Jochen0x90h/RoomControl_old/(list of files, cad)

Other CAD files:
cad/box.scad
