Jochen0x90h/RoomControl_old/hardware/main/main.kicad_pcb

## KiCad design hardware/main/main.kicad_pcb (2020-09-15)

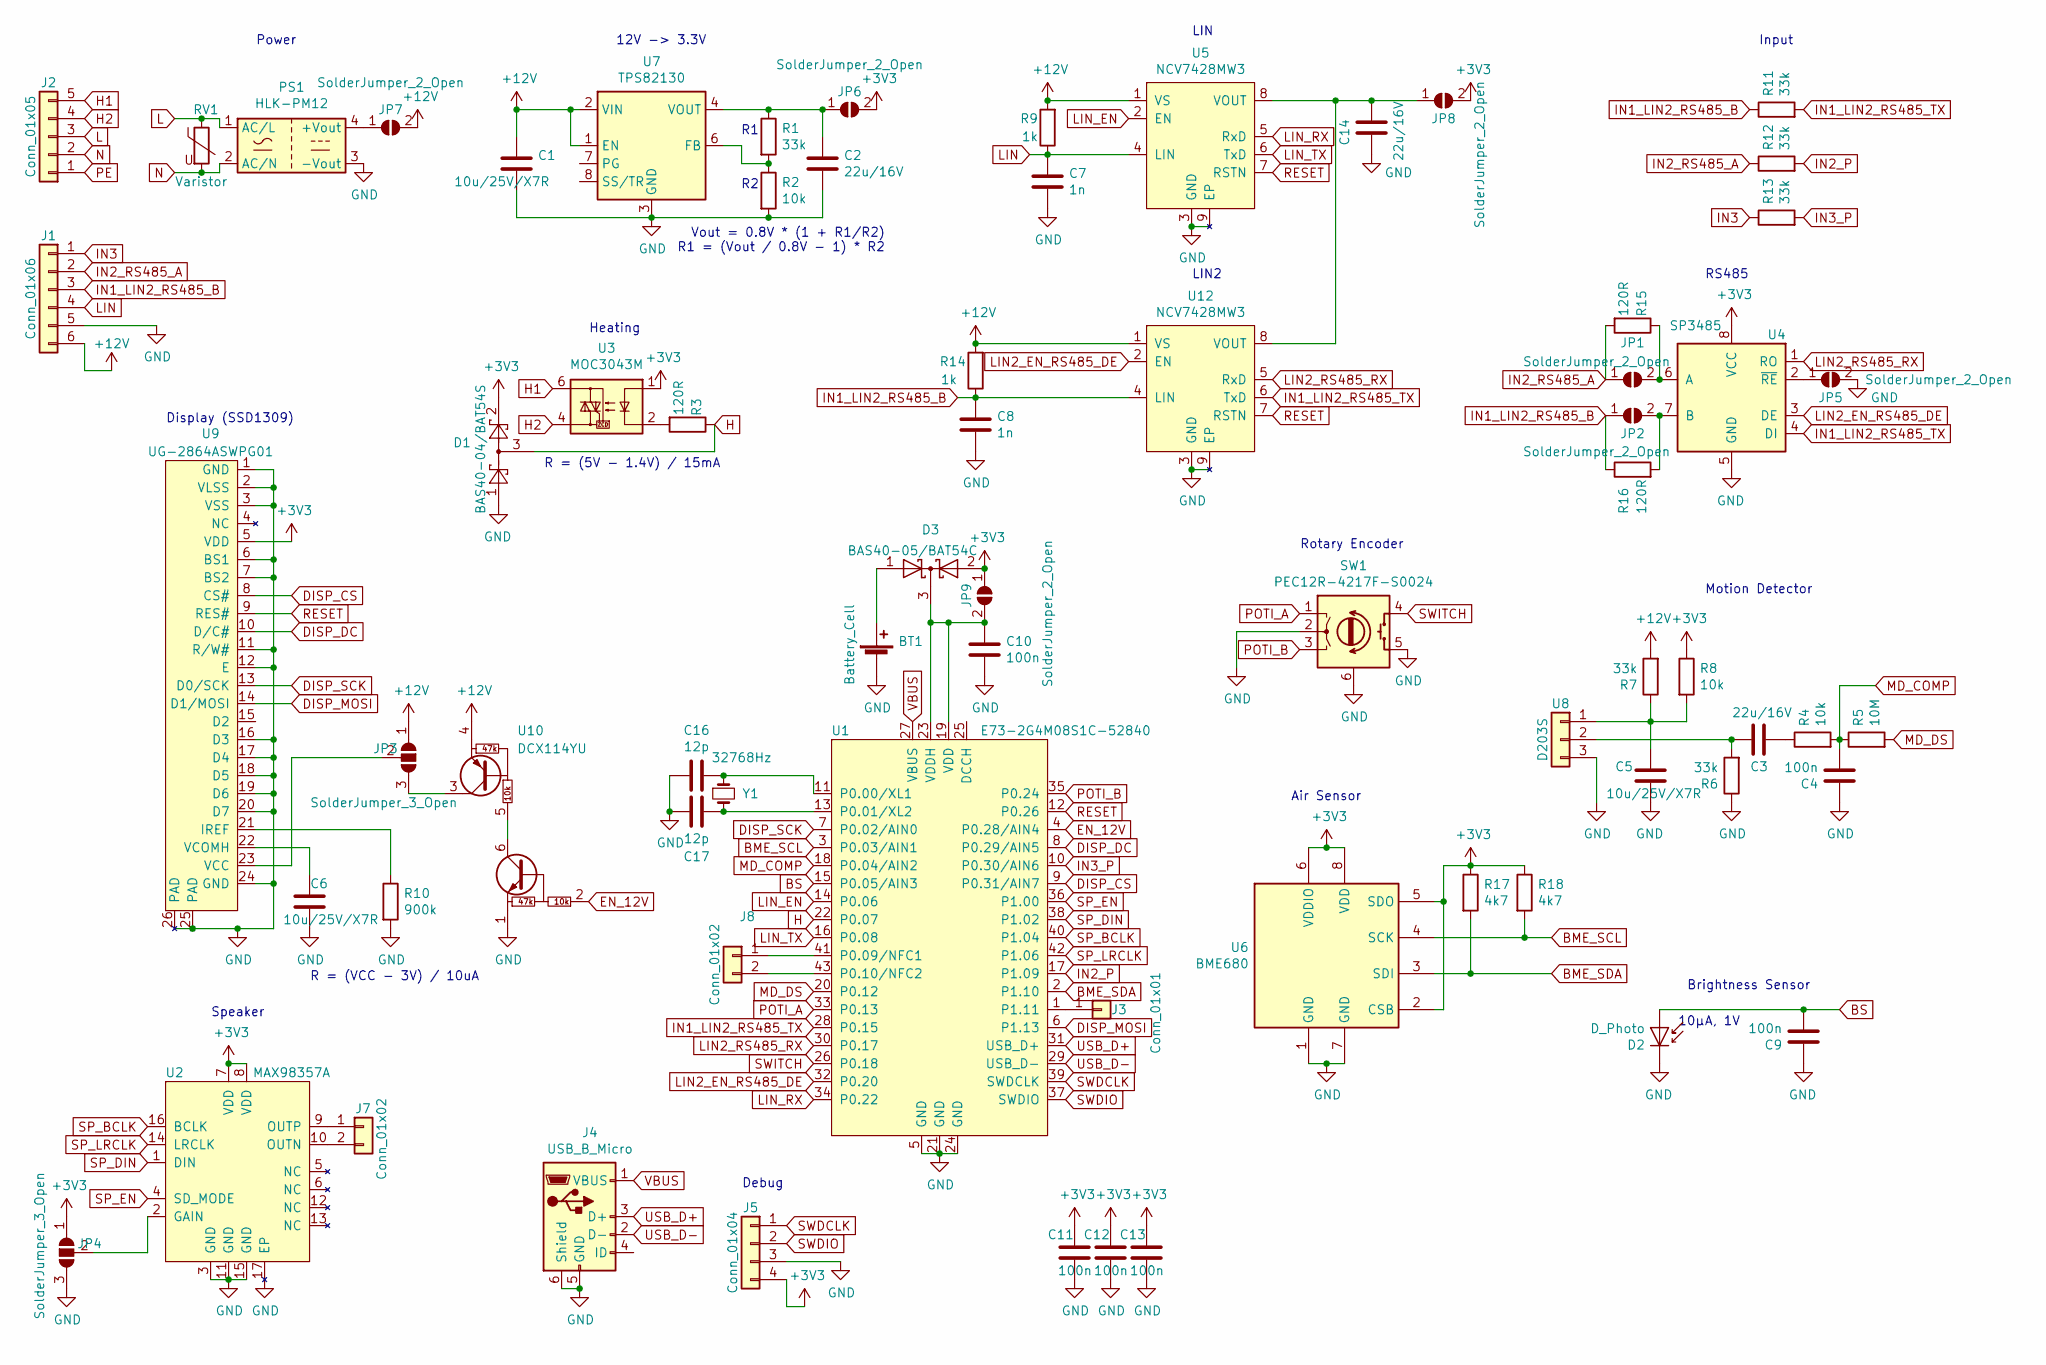
[picture p1: schematic main.sch]

Parts:
BT1: Battery_Cell; Battery_2032
C1, C5, C6: 10u/25V/X7R; C_1206_3216Metric
C2, C3, C14: 22u/16V; C_0805_2012Metric
C4, C9, C10, C11, C12, C13: 100n; C_0603_1608Metric
C7, C8: 1n; C_0603_1608Metric
C16, C17: 12p; C_0603_1608Metric
D1: BAS40-04/BAT54S; SOT-23
D2: D_Photo; DiodeHoles
D3: BAS40-05/BAT54C; SOT-23
J1: Conn_01x06; Wago_236-406
J2: Conn_01x05; Wago_236-405
J3: Conn_01x01; Pad
J4: USB_B_Micro; USB_Micro-B
J5: Conn_01x04; PinHeader_1x04_P2.54mm_Vertical
J7: Conn_01x02; PinHeader_1x02_P2.54mm_Vertical
J8: Conn_01x02; PinHeader_1x02_P2.00mm_Vertical
JP1, JP2, JP5, JP6, JP7, JP8, JP9: SolderJumper_2_Open; Jumper2
JP3, JP4: SolderJumper_3_Open; Jumper3
PS1: HLK-PM12; HiLink_HLK-PMxx
R1, R6, R7: 33k; R_0603_1608Metric
R2, R4, R8: 10k; R_0603_1608Metric
R3, R15, R16: 120R; R_1206_3216Metric
R5: 10M; R_0603_1608Metric
R9, R14: 1k; R_1206_3216Metric
R10: 900k; R_0603_1608Metric
R11, R12, R13: 33k; R_1206_3216Metric
R17, R18: 4k7; R_0603_1608Metric
RV1: Varistor; S10K275
SW1: PEC12R-4217F-S0024; Bourns_PEC12R
U1: E73-2G4M08S1C-52840
U2: MAX98357A; TQFN-16-1EP_3x3mm_P0.5mm_EP1.23x1.23mm
U3: MOC3043M; On_MOC3043
U4: SP3485; SOIC-8_3.9x4.9mm_P1.27mm
U5, U12: NCV7428MW3; On_NCV7428MW
U6: BME680; Bosch_BME680
U7: TPS82130; Texas_TPS82130
U8: D203S
U9: UG-2864ASWPG01; Connector-Flat-24_P0.5mm
U10: DCX114YU; SOT-363_SC-70-6
Y1: 32768Hz; Crystal_DS26_D2.0mm_L6.0mm_Vertical

Connections:
+3V3: C11.2, C12.2, C13.2, D1.2, D3.2 (A), J5.4, JP4.1 (A), JP6.2 (B), JP8.2 (B), JP9.1 (A), R8.1, R17.1, R18.1, U2.7 (VDD), U2.8 (VDD), U3.1, U4.8 (VCC), U6.2 (CSB), U6.5 (SDO), U6.6 (VDDIO), U6.8 (VDD), U9.5 (VDD)
+12V: C1.1, J1.6, JP3.1 (A), JP7.2 (B), R7.2, R9.2, R14.2, U5.1 (VS), U7.1 (EN), U7.2 (VIN), U10.4 (C2), U12.1 (VS)
BME_SCL: R18.2, U1.3 (P0.03/AIN1), U6.4 (SCK)
BME_SDA: R17.2, U1.2 (P1.10), U6.3 (SDI)
BS: C9.2, D2.2 (A), U1.15 (P0.05/AIN3)
DISP_CS: U1.9 (P0.31/AIN7), U9.8 (CS#)
DISP_DC: U1.8 (P0.29/AIN5), U9.10 (D/C#)
DISP_MOSI: U1.6 (P1.13), U9.14 (D1/MOSI)
DISP_SCK: U1.7 (P0.02/AIN0), U9.13 (D0/SCK)
EN_12V: U1.4 (P0.28/AIN4), U10.2 (B1)
GND: BT1.2 (-), C1.2, C2.2, C4.1, C5.2, C6.2, C7.2, C8.2, C9.1, C10.2, C11.1, C12.1, C13.1, C14.1, C16.2, C17.2, D1.1, D2.1 (K), J1.5, J4.5 (GND), J4.6 (Shield), J5.3, JP4.3 (B), JP5.2 (B), PS1.3 (-Vout), R2.2, R6.1, R10.2, SW1.2 (C), SW1.5 (S2), SW1.6 (SH), U1.5 (GND), U1.21 (GND), U1.24 (GND), U2.3 (GND), U2.11 (GND), U2.15 (GND), U2.17 (EP), U4.5 (GND), U5.3 (GND), U5.9 (EP), U6.1 (GND), U6.7 (GND), U7.3 (GND), U7.9 (GND), U8.3, U9.1 (GND), U9.2 (VLSS), U9.3 (VSS), U9.6 (BS1), U9.7 (BS2), U9.11 (R/W#), U9.12 (E), U9.16 (D3), U9.17 (D4), U9.18 (D5), U9.19 (D6), U9.20 (D7), U9.24 (GND), U9.25 (PAD), U9.26 (PAD), U10.1 (E1), U12.3 (GND), U12.9 (EP)
H: D1.3, R3.1, U1.22 (P0.07)
H1: J2.5, U3.6
H2: J2.4, U3.4
IN1_LIN2_RS485_B: C8.1, J1.3, JP2.1 (A), R11.1, R14.1, R16.1, U12.4 (LIN)
IN1_LIN2_RS485_TX: R11.2, U1.28 (P0.15), U4.4 (DI), U12.6 (TxD)
IN2_P: R12.2, U1.17 (P1.09)
IN2_RS485_A: J1.2, JP1.1 (A), R12.1, R15.2
IN3: J1.1, R13.1
IN3_P: R13.2, U1.10 (P0.30/AIN6)
L: J2.3, PS1.1 (AC/L), RV1.1
LIN: C7.1, J1.4, R9.1, U5.4 (LIN)
LIN2_EN_RS485_DE: U1.32 (P0.20), U4.3 (DE), U12.2 (EN)
LIN2_RS485_RX: U1.30 (P0.17), U4.1 (RO), U12.5 (RxD)
LIN_EN: U1.14 (P0.06), U5.2 (EN)
LIN_RX: U1.34 (P0.22), U5.5 (RxD)
LIN_TX: U1.16 (P0.08), U5.6 (TxD)
MD_COMP: C4.2, R4.2, R5.1, U1.18 (P0.04/AIN2)
MD_DS: R5.2, U1.20 (P0.12)
N: J2.2, PS1.2 (AC/N), RV1.2
unnamed: BT1.1 (+), D3.1 (A)
unnamed: C2.1, JP6.1 (A), R1.1, U7.4 (VOUT), U7.5 (VOUT)
unnamed: C3.1, R4.1
unnamed: C3.2, R6.2, U8.2
unnamed: C5.1, R7.1, R8.2, U8.1
unnamed: C6.1, U9.22 (VCOMH)
unnamed: C10.1, D3.3 (K), JP9.2 (B), U1.19 (VDD), U1.23 (VDDH)
unnamed: C14.2, JP8.1 (A), U5.8 (VOUT), U12.8 (VOUT)
unnamed: C16.1, U1.11 (P0.00/XL1), Y1.1
unnamed: C17.1, U1.13 (P0.01/XL2), Y1.2
unnamed: J3.1, U1.1 (P1.11)
unnamed: J7.1, U2.9 (OUTP)
unnamed: J7.2, U2.10 (OUTN)
unnamed: J8.1, U1.41 (P0.09/NFC1)
unnamed: J8.2, U1.43 (P0.10/NFC2)
unnamed: JP1.2 (B), R15.1, U4.6 (A)
unnamed: JP2.2 (B), R16.2, U4.7 (B)
unnamed: JP3.2 (C), U9.23 (VCC)
unnamed: JP3.3 (B), U10.3 (C2)
unnamed: JP4.2 (C), U2.2 (GAIN)
unnamed: JP5.1 (A), U4.2 (~RE~)
unnamed: JP7.1 (A), PS1.4 (+Vout)
unnamed: R1.2, R2.1, U7.6 (FB)
unnamed: R3.2, U3.2
unnamed: R10.1, U9.21 (IREF)
unnamed: U10.5 (B2), U10.6 (C1)
PE: J2.1
POTI_A: SW1.1 (A), U1.33 (P0.13)
POTI_B: SW1.3 (B), U1.35 (P0.24)
RESET: U1.12 (P0.26), U5.7 (RSTN), U9.9 (RES#), U12.7 (RSTN)
SP_BCLK: U1.40 (P1.04), U2.16 (BCLK)
SP_DIN: U1.38 (P1.02), U2.1 (DIN)
SP_EN: U1.36 (P1.00), U2.4 (SD_MODE)
SP_LRCLK: U1.42 (P1.06), U2.14 (LRCLK)
SWDCLK: J5.1, U1.39 (SWDCLK)
SWDIO: J5.2, U1.37 (SWDIO)
SWITCH: SW1.4 (S1), U1.26 (P0.18)
USB_D+: J4.3 (D+), U1.31 (USB_D+)
USB_D-: J4.2 (D-), U1.29 (USB_D-)
VBUS: J4.1 (VBUS), U1.27 (VBUS)

Notes on the sheet:
Vout = 0.8V * (1 + R1/R2) R1 = (Vout / 0.8V - 1) * R2
R = (VCC - 3V) / 10uA
Motion Detector
Display (SSD1309)
Speaker
Brightness Sensor
Input
LIN
RS485
12V -> 3.3V
Rotary Encoder
Air Sensor
Power
Heating
10µA, 1V
R = (5V - 1.4V) / 15mA
LIN2
Debug

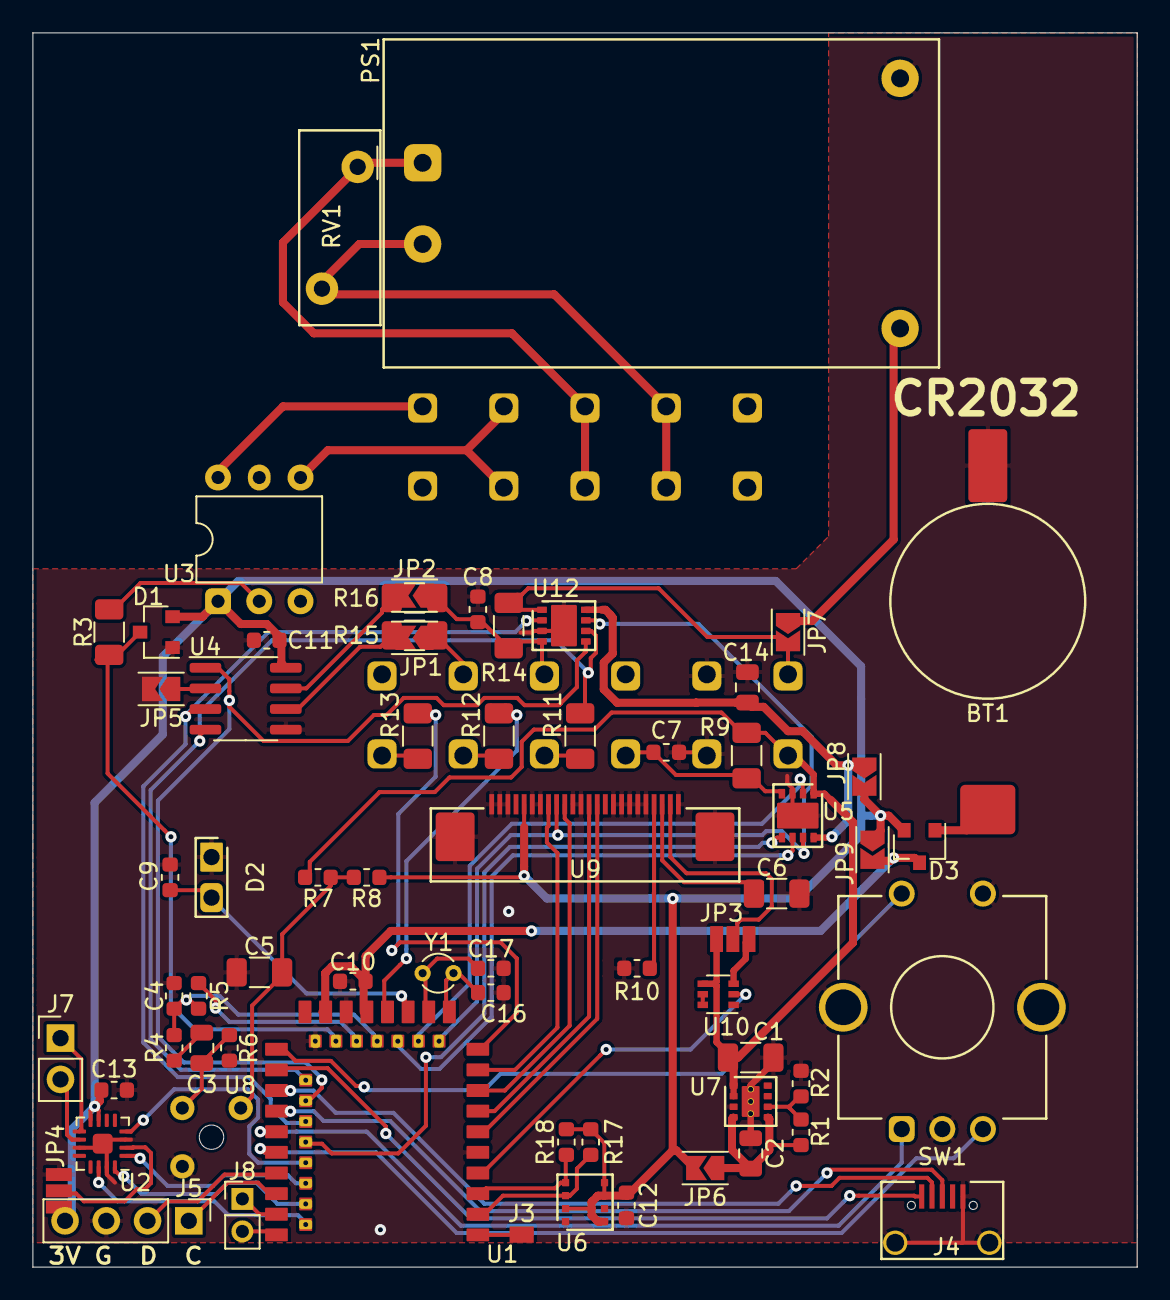
[picture p2: board main.kicad_pcb from above]

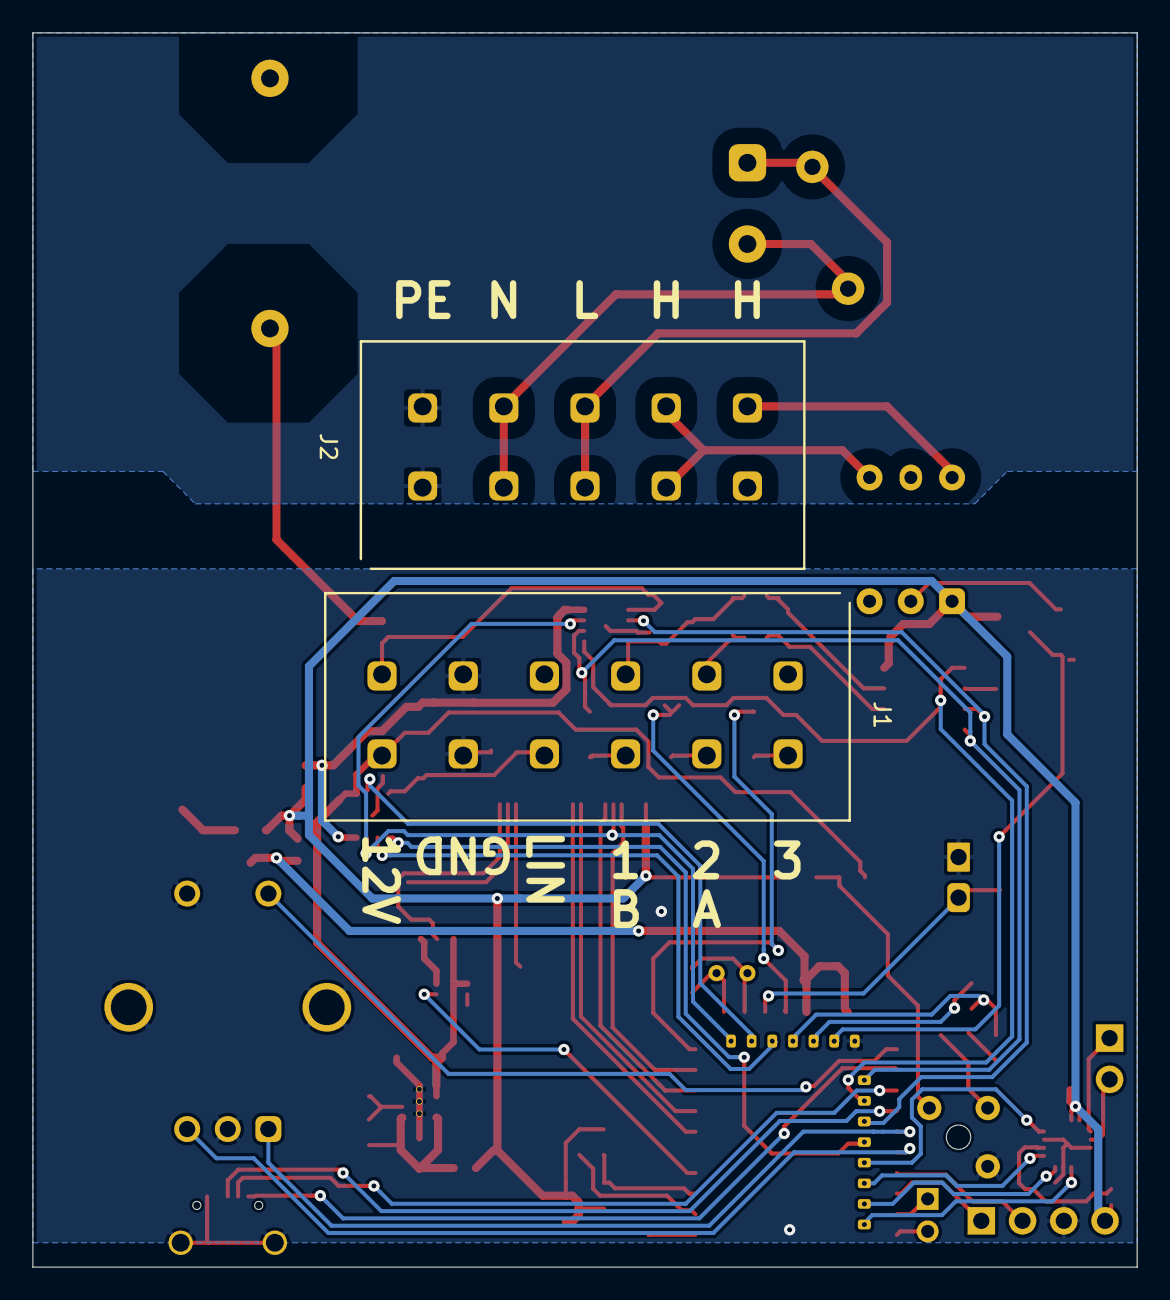
[picture p3: board main.kicad_pcb from below]

Board: 2 copper layers, 68.0 x 76.0 mm, 69 parts (2 on the bottom side), 69 nets.
