Jochen0x90h/RoomControl_old/hardware/switch/switch.kicad_pcb

## KiCad design hardware/switch/switch.kicad_pcb (2020-09-15)

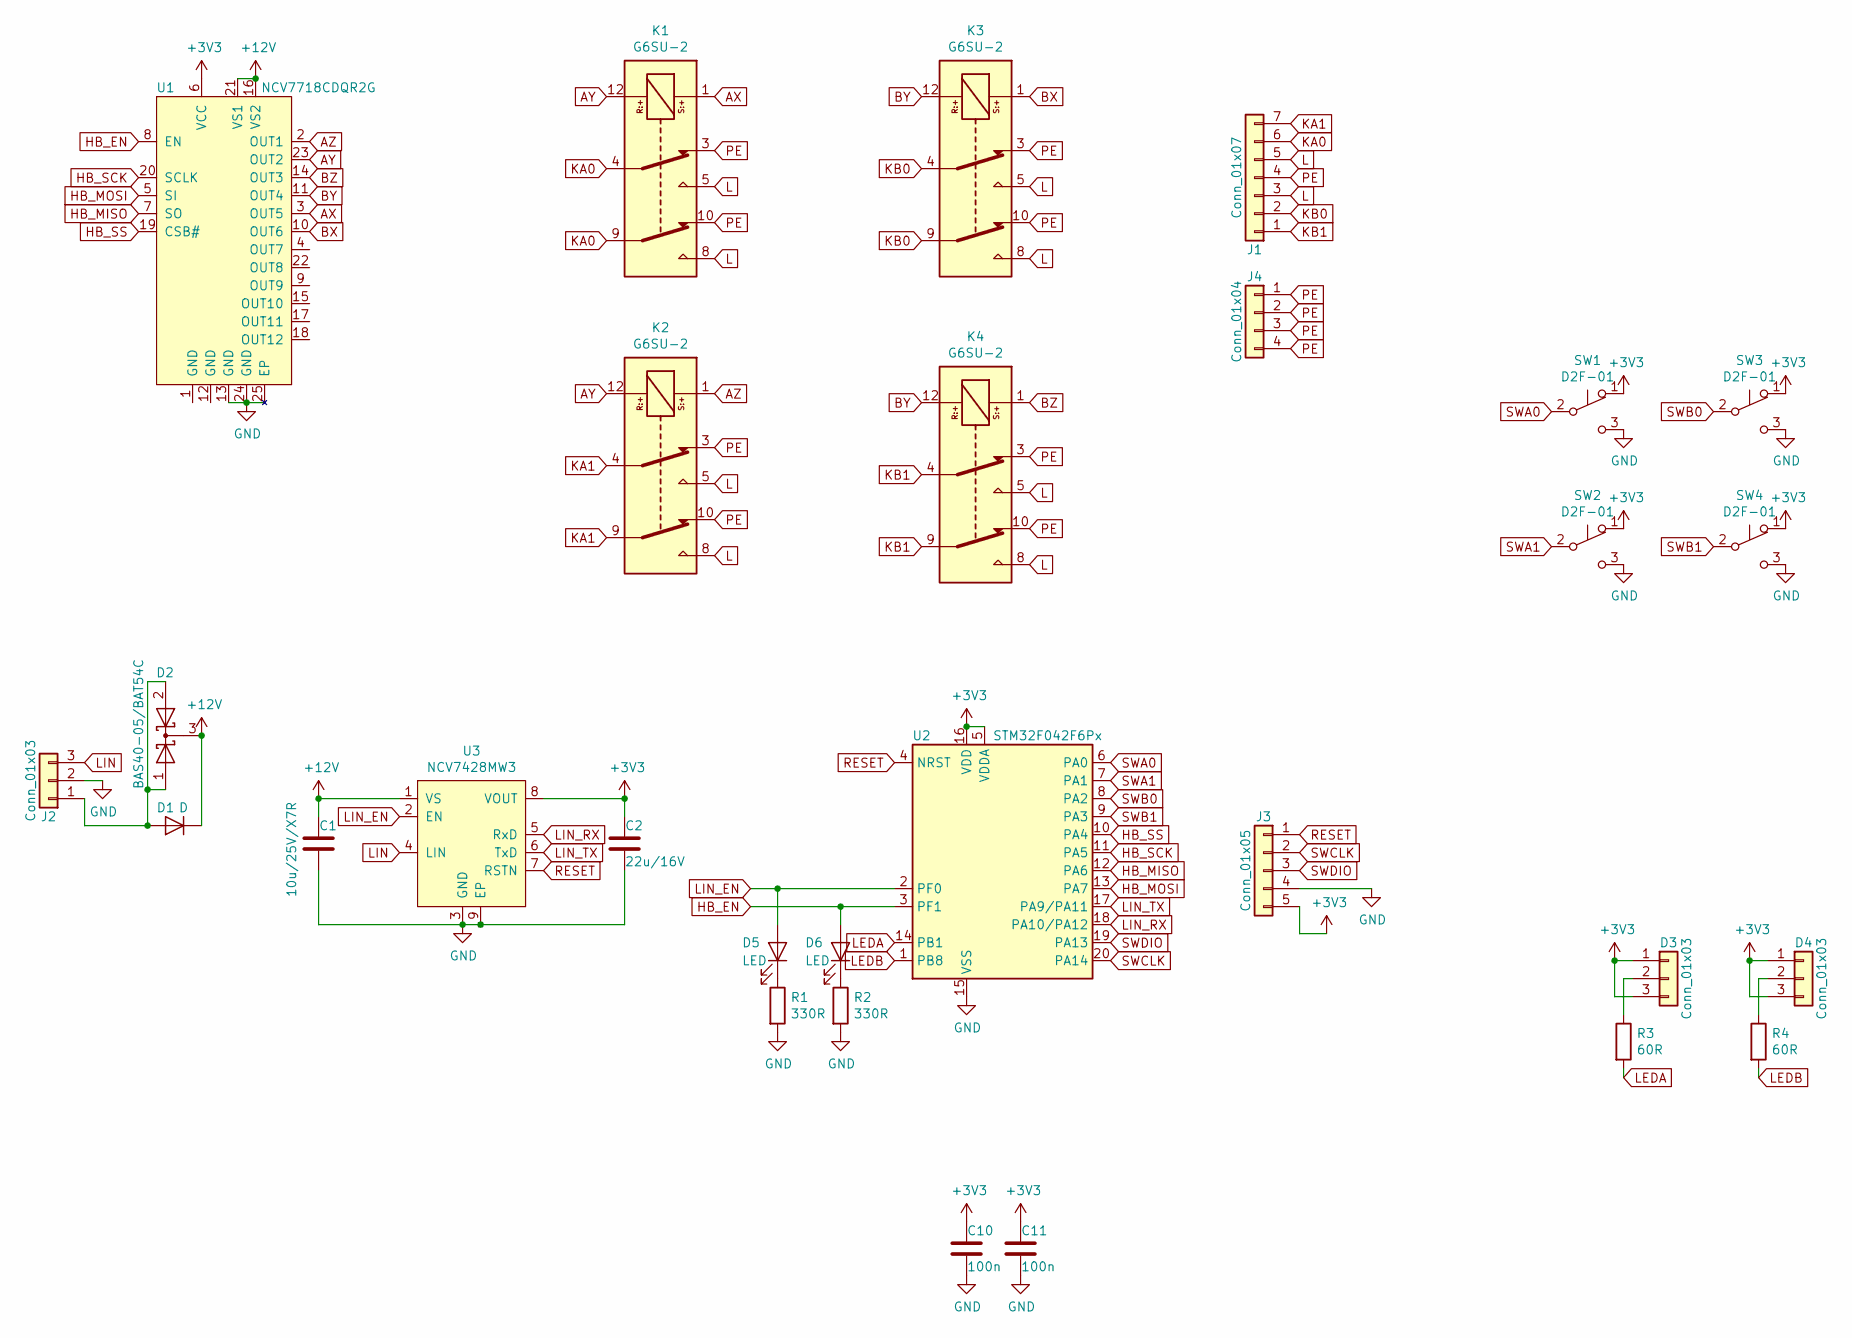
[picture p4: schematic switch.sch]

Parts:
C1: 10u/25V/X7R; C_1206_3216Metric
C2: 22u/16V; C_0805_2012Metric
C10, C11: 100n; C_0603_1608Metric
D1: D; D_1206_3216Metric_Castellated
D2: BAS40-05/BAT54C; SOT-23
D3, D4: Conn_01x03; DiodeHoles3
D5, D6: LED; LED_0805_2012Metric_Castellated
J1: Conn_01x07; Wago_236-407
J2: Conn_01x03; Wago_236-403
J3: Conn_01x05; PinHeader_1x05_P2.54mm_Vertical
J4: Conn_01x04; Switch_Mount
K1, K2, K3, K4: G6SU-2; Omron_G6SU-2
R1, R2: 330R; R_0603_1608Metric
R3, R4: 60R; R_0603_1608Metric
SW1, SW2, SW3, SW4: D2F-01; Omron_D2F-01
U1: NCV7718CDQR2G; On_NCV77xx
U2: STM32F042F6Px; STM32F042F6
U3: NCV7428MW3; On_NCV7428MW

Connections:
+3V3: C2.1, C10.1, C11.1, D3.1, D3.3, D4.1, D4.3, J3.5, SW1.1 (A), SW2.1 (A), SW3.1 (A), SW4.1 (A), U1.6 (VCC), U2.5 (VDDA), U2.16 (VDD), U3.8 (VOUT)
+12V: C1.1, D1.1 (K), D2.3 (K), U1.16 (VS2), U1.21 (VS1), U3.1 (VS)
AX: K1.1, U1.3 (OUT5)
AY: K1.12, K2.12, U1.23 (OUT2)
AZ: K2.1, U1.2 (OUT1)
BX: K3.1, U1.10 (OUT6)
BY: K3.12, K4.12, U1.11 (OUT4)
BZ: K4.1, U1.14 (OUT3)
GND: C1.2, C2.2, C10.2, C11.2, J2.2, J3.4, R1.2, R2.2, SW1.3 (C), SW2.3 (C), SW3.3 (C), SW4.3 (C), U1.13 (GND), U1.24 (GND), U1.25 (EP), U2.15 (VSS), U3.3 (GND), U3.9 (EP)
HB_EN: D6.2 (A), U1.8 (EN), U2.3 (PF1)
HB_MISO: U1.7 (SO), U2.12 (PA6)
HB_MOSI: U1.5 (SI), U2.13 (PA7)
HB_SCK: U1.20 (SCLK), U2.11 (PA5)
HB_SS: U1.19 (CSB#), U2.10 (PA4)
KA0: J1.6, K1.4, K1.9
KA1: J1.7, K2.4, K2.9
KB0: J1.2, K3.4, K3.9
KB1: J1.1, K4.4, K4.9
L: J1.3, J1.5, K1.5, K1.8, K2.5, K2.8, K3.5, K3.8, K4.5, K4.8
LEDA: R3.2, U2.14 (PB1)
LEDB: R4.2, U2.1 (PB8)
LIN: J2.3, U3.4 (LIN)
LIN_EN: D5.2 (A), U2.2 (PF0), U3.2 (EN)
LIN_RX: U2.18 (PA10/PA12), U3.5 (RxD)
LIN_TX: U2.17 (PA9/PA11), U3.6 (TxD)
unnamed: D1.2 (A), D2.1 (A), D2.2 (A), J2.1
unnamed: D3.2, R3.1
unnamed: D4.2, R4.1
unnamed: D5.1 (K), R1.1
unnamed: D6.1 (K), R2.1
PE: J1.4, J4.1, J4.2, J4.3, J4.4, K1.3, K1.10, K2.3, K2.10, K3.3, K3.10, K4.3, K4.10
RESET: J3.1, U2.4 (NRST), U3.7 (RSTN)
SWA0: SW1.2 (B), U2.6 (PA0)
SWA1: SW2.2 (B), U2.7 (PA1)
SWB0: SW3.2 (B), U2.8 (PA2)
SWB1: SW4.2 (B), U2.9 (PA3)
SWCLK: J3.2, U2.20 (PA14)
SWDIO: J3.3, U2.19 (PA13)

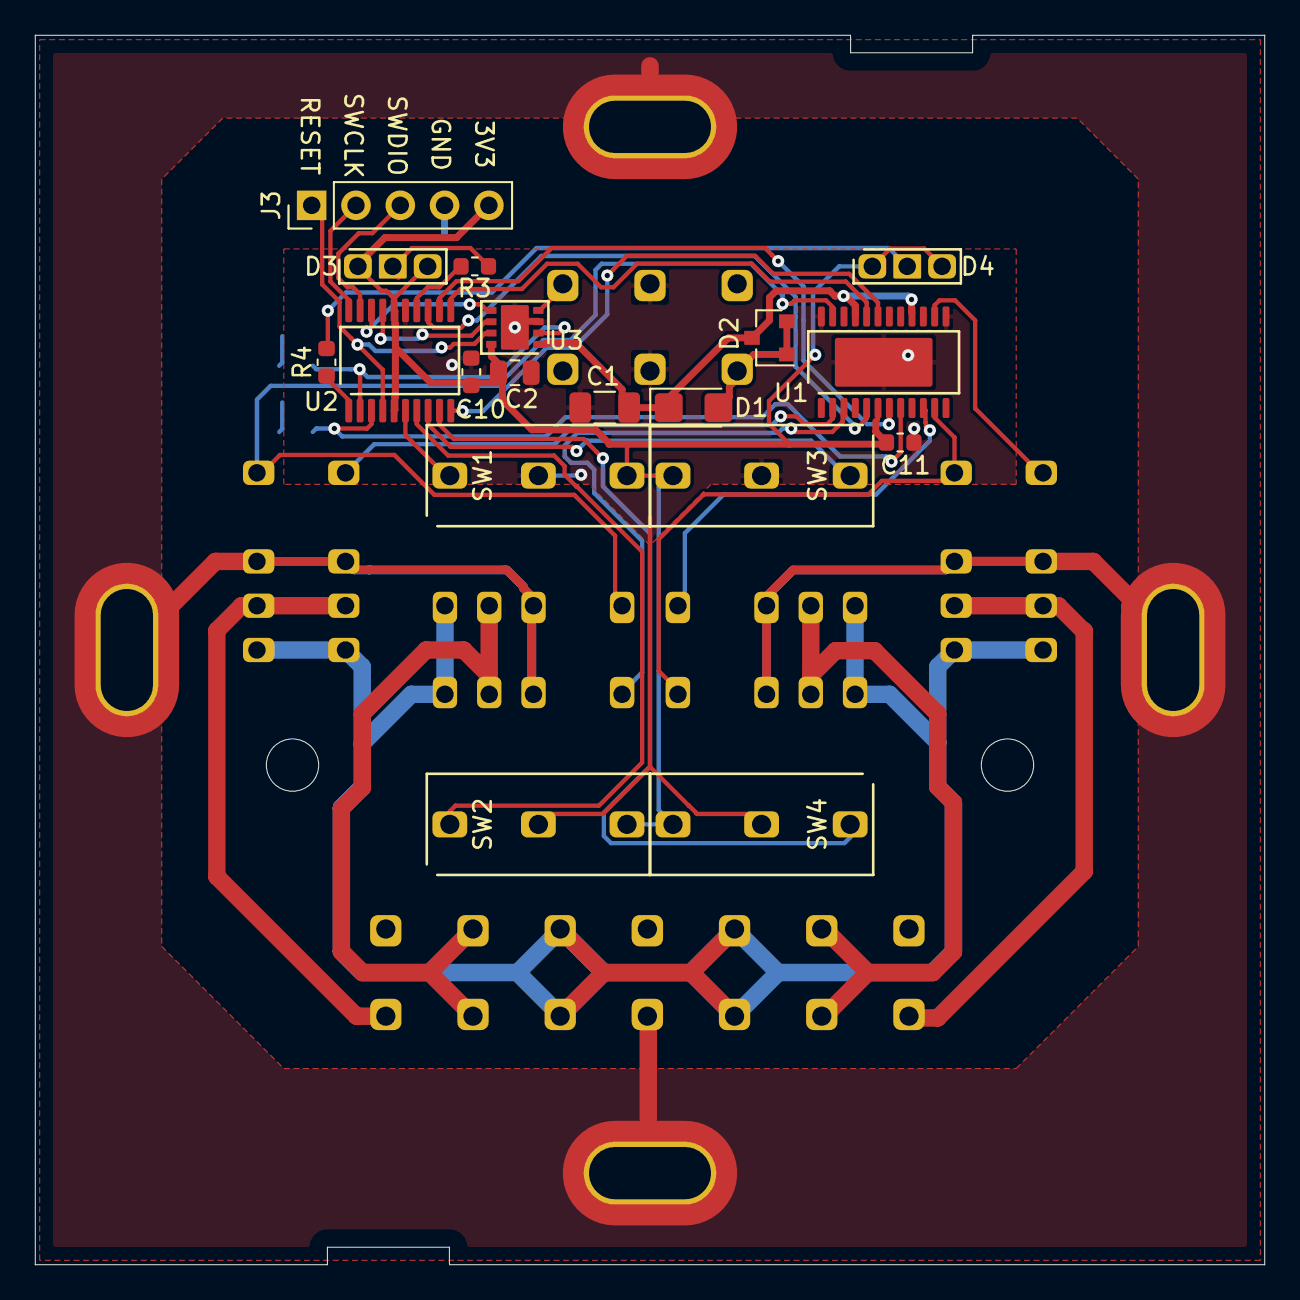
[picture p5: board switch.kicad_pcb from above]

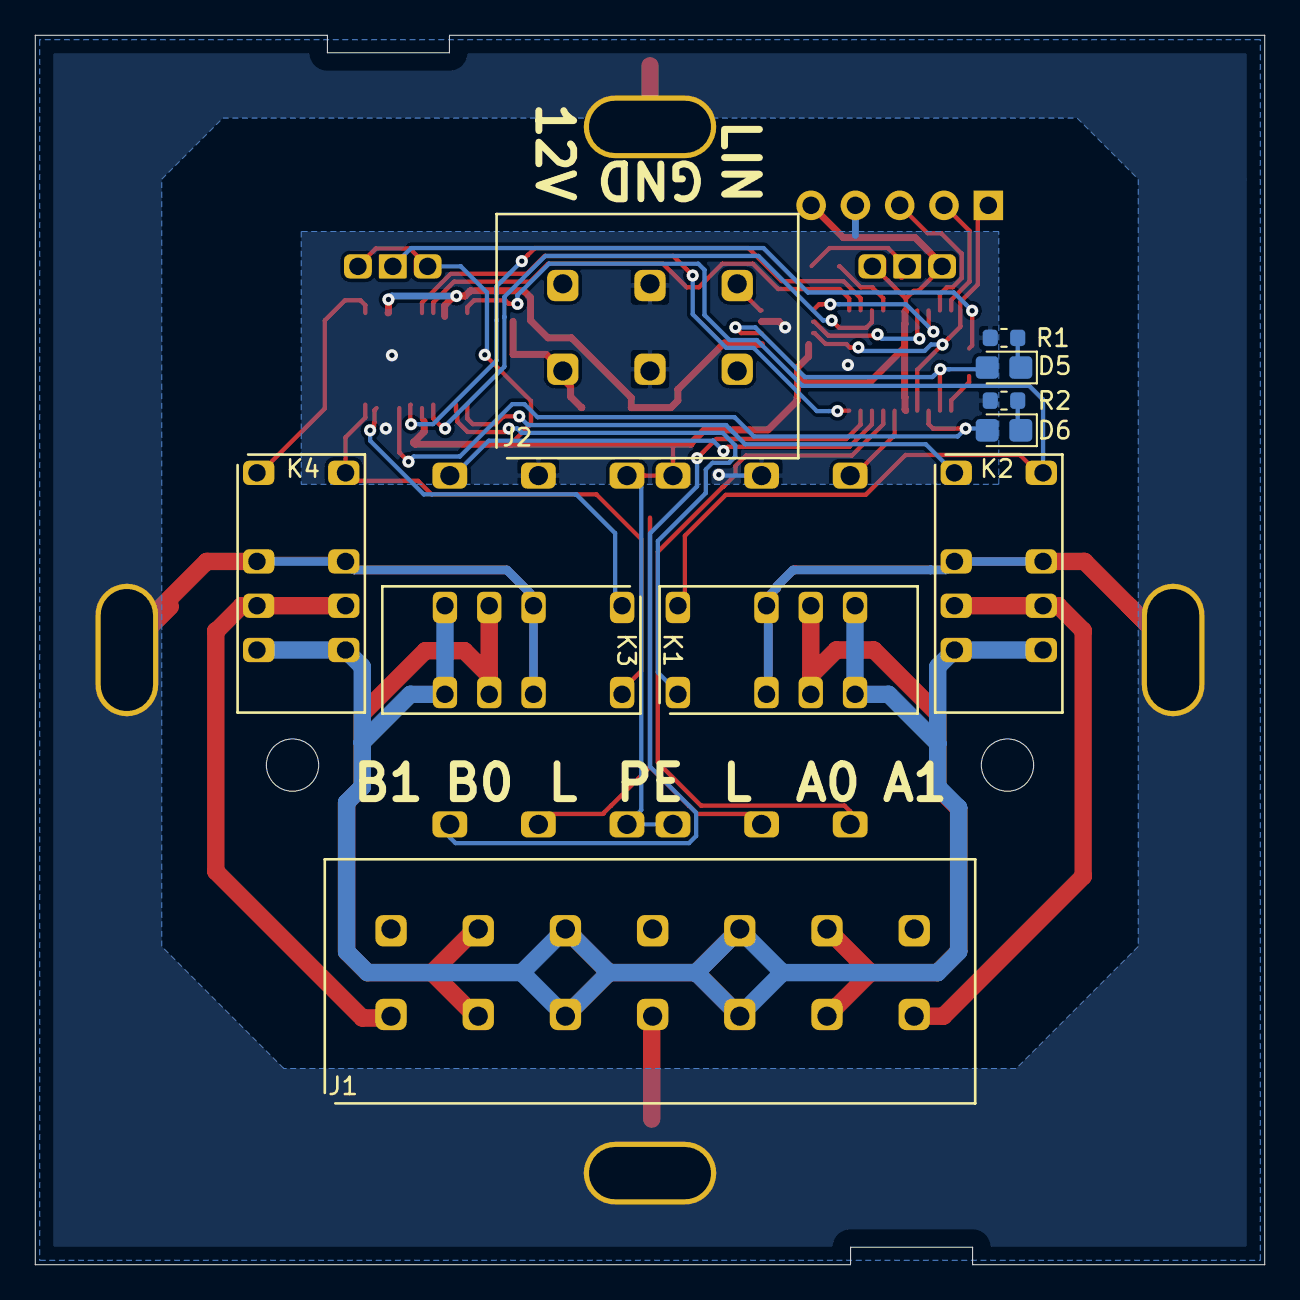
[picture p6: board switch.kicad_pcb from below]

Board: 2 copper layers, 70.5 x 70.5 mm, 29 parts (10 on the bottom side), 38 nets.
