Jochen0x90h/RoomControl_old/software/Array.hpp

#pragma once

#include <stdint.h>


template <typename T>
struct Array {
	const T *data;
	int length;
		
	constexpr Array() : data(nullptr), length(0) {}

	template <int N>
	constexpr Array(const T (&array)[N]) : data(array), length(N) {}

	constexpr Array(const T *data, int length) : data(data), length(length) {}

	constexpr const T &operator [](int index) const {return this->data[index];}

	const T *begin() const {return this->data;}
	const T *end() const {return this->data + this->length;}
};
