Jochen0x90h/RoomControl_old/software/Bitmap.cpp

#include "Bitmap.hpp"


void fillBitmap(int w, int h, uint8_t *data, int x, int y, int width, int height, Mode mode)
{
	if (mode == Mode::KEEP)
		return;
	
	// clamp to border
	if (x < 0) {
		width += x;
		x = 0;
	}
	if (y < 0) {
		height += y;
		y = 0;
	}
	if (x + width > w) {
		width = w - x;
	}
	if (y + height > h) {
		height = h - y;
	}
	if (width <= 0 || height <= 0)
		return;
	
	int endRows = (y + height) & 7;
	uint8_t *page = &data[(y >> 3) * w] + x;
	uint8_t *pageEnd = &data[((y + height) >> 3) * w] + x;

	// first page
	{
		uint8_t mask = 0xff << (y & 7);
		if (page == pageEnd && endRows > 0) {
			mask &= 0xff >> (8 - endRows);
			endRows = 0;
		}
		for (int i = 0; i < width; ++i) {
			switch (mode) {
			case Mode::CLEAR:
				page[i] &= ~mask;
				break;
			case Mode::FLIP:
				page[i] ^= mask;
				break;
			default:
				page[i] |= mask;
				break;
			}
		}
		page += w;
	}
	
	// full pages
	while (page < pageEnd) {
		for (int i = 0; i < width; ++i) {
			switch (mode) {
			case Mode::CLEAR:
				page[i] = 0;
				break;
			case Mode::FLIP:
				page[i] ^= 0xff;
				break;
			default:
				page[i] = 0xff;
				break;
			}
		}
		page += w;
	}

	// last page
	if (endRows > 0) {
		uint8_t mask = 0xff >> (8 - endRows);
		for (int i = 0; i < width; ++i) {
			switch (mode) {
			case Mode::CLEAR:
				page[i] &= ~mask;
				break;
			case Mode::FLIP:
				page[i] ^= mask;
				break;
			default:
				page[i] |= mask;
				break;
			}
		}
		page += w;
	}
}

void copyBitmapH(int w, int h, uint8_t *data, int x, int y, int width, int height, const uint8_t *bitmap,
	Mode frontMode, Mode backMode)
{
	if (frontMode == Mode::KEEP && backMode == Mode::KEEP)
		return;

	// number of bytes in a row of the bitmap
	int bitmapStride = (width + 7) >> 3;

	// clamp to border
	int o = 0;
	if (x < 0) {
		o = -x;
		width += x;
		x = 0;
	}
	if (y < 0) {
		bitmap += -y * bitmapStride;
		height += y;
		y = 0;
	}
	if (x + width > w) {
		width = w - x;
	}
	if (y + height > h) {
		height = h - y;
	}

	// bitmap
	for (int j = 0; j < height; ++j) {
		uint8_t *page = &data[((y + j) >> 3) * w] + x;
		
		for (int i = 0; i < width; ++i) {
			uint8_t bit = 1 << ((y + j) & 7);
			if (bitmap[(o + i) >> 3] & (0x80 >> ((o + i) & 7))) {
				switch (frontMode) {
				case Mode::CLEAR:
					page[i] &= ~bit;
					break;
				case Mode::FLIP:
					page[i] ^= bit;
					break;
				case Mode::SET:
					page[i] |= bit;
				default:
					break;
				}
			} else {
				switch (backMode) {
				case Mode::CLEAR:
					page[i] &= ~bit;
					break;
				case Mode::FLIP:
					page[i] ^= bit;
					break;
				case Mode::SET:
					page[i] |= bit;
				default:
					break;
				}
			}
		}
		bitmap += bitmapStride;
	}
}
