Jochen0x90h/RoomControl_old/(commit log)

2019-09-16 Add menus for buttons and scenarios and flash emulator
2019-10-15 Add timers and temperature control
2019-11-10 Switch to device (state machine) concept
2019-11-23 Add motion sensor to emulator
2020-02-03 Add file structure for stm32f0
2020-05-16 Add Hardware
    [main.kicad_pcb, main.sch]
2020-05-17 Add openscad models for box and switch
    [box.scad, switch.scad]
2020-05-29 Add pcb for switch
    [switch.kicad_pcb, switch.scad, switch.sch]
2020-06-13 Use LIN instead of CAN transciever
    [switch.kicad_pcb, switch.scad, switch.sch]
2020-07-19 Update main board to use LIN
    [box.scad, main.kicad_pcb, main.sch, switch.kicad_pcb, switch.sch]
2020-08-07 Add backup battery and 32768Hz crystal
    [box.scad, main.kicad_pcb, main.sch, switch.kicad_pcb, switch.sch]
2020-08-20 New speaker and pir sensor lens
    [box.scad, main.kicad_pcb, main.sch, switch.kicad_pcb, switch.scad]
2020-09-15 Add indicator LEDs to switch
    [main.kicad_pcb, main.sch, switch.kicad_pcb, switch.scad, switch.sch]
